AnnaCarazzaGit/lteb_PAT_project/Report/Gruppo_3_Laboratorio_di_Elettronica_e_Biosensori/PPGvistaalto.jpeg

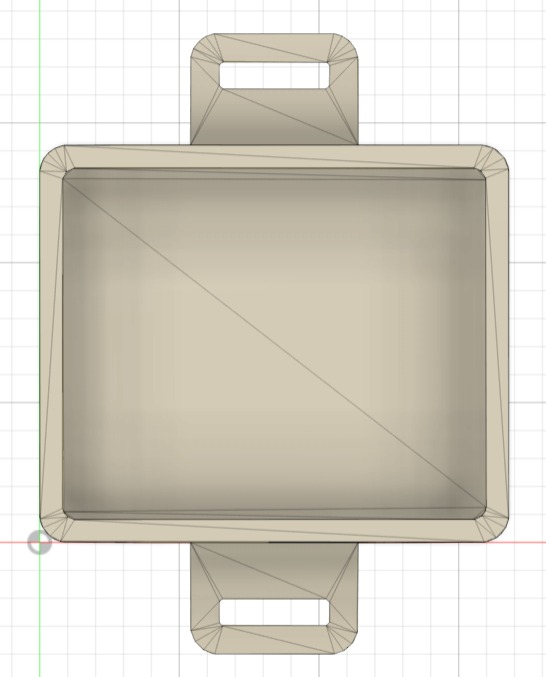
Report/Gruppo_3_Laboratorio_di_Elettronica_e_Biosensori/PPGvistaalto.jpeg
